21trebor09/Arduino-Linefollower/(commit log)

2025-05-28 need to to results and sensor documentation
2025-05-29 updated wiring and added results
